garrett-archery/universal-finger-tab/README.md

# Universal Finger Tab

The goal of this project is to develop one finger tab that will work for every user.

Fork the repository to create your own project based on the Universal Finger Tab design.
Branch the Universal Finger Tab repository to propose changes to the Master. 

A production version of this project is available for purchase at <a href="https://garrettarchery.com/product/universal-finger-tab/">GarrettArchery.com</a>
