garrett-archery/universal-finger-tab/palm plate.step

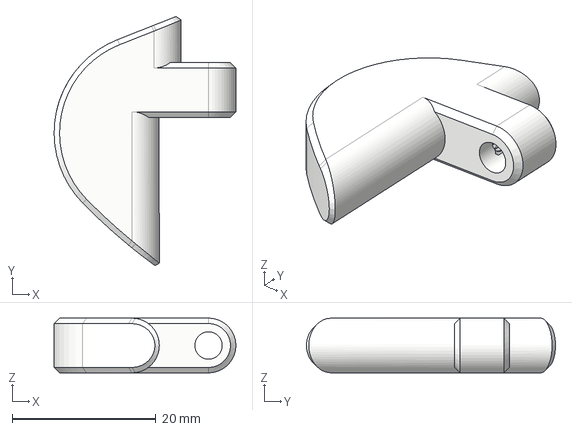
[picture p3: CAD file, 2019-08-01]
palm plate.step
25.3 x 34.7 x 7.62 mm
