garrett-archery/universal-finger-tab/Right hand/shelf - right-hand.step

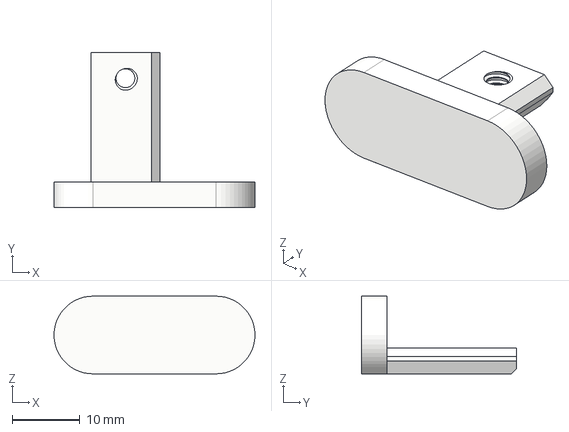
[picture p4: CAD file, 2019-08-01]
Right hand/shelf - right-hand.step
29.6 x 22.9 x 11.4 mm
