garrett-archery/universal-finger-tab/Left hand/finger spacer - left-hand.step

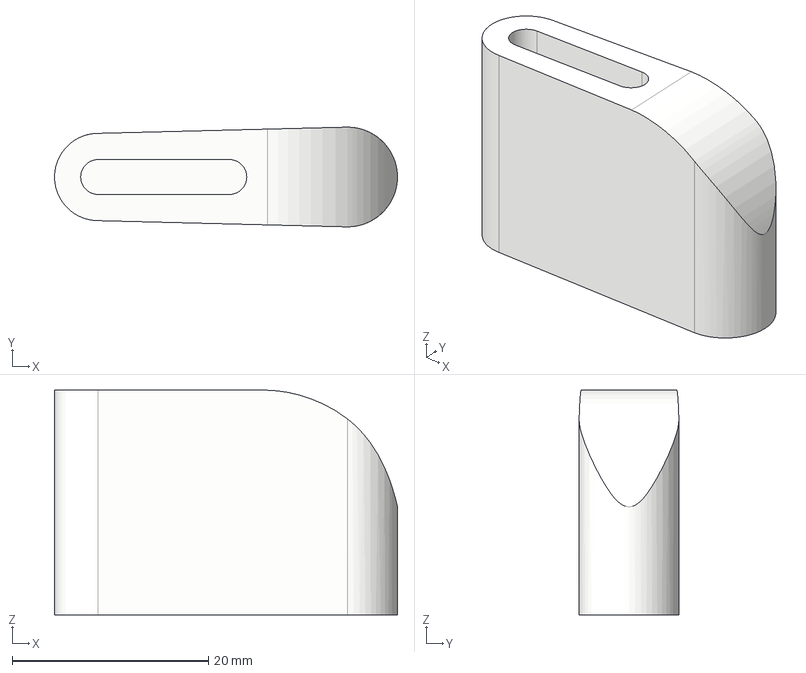
[picture p5: CAD file, 2019-08-01]
Left hand/finger spacer - left-hand.step
34.9 x 10.2 x 22.9 mm
