garrett-archery/universal-finger-tab/finger alignment plate.step

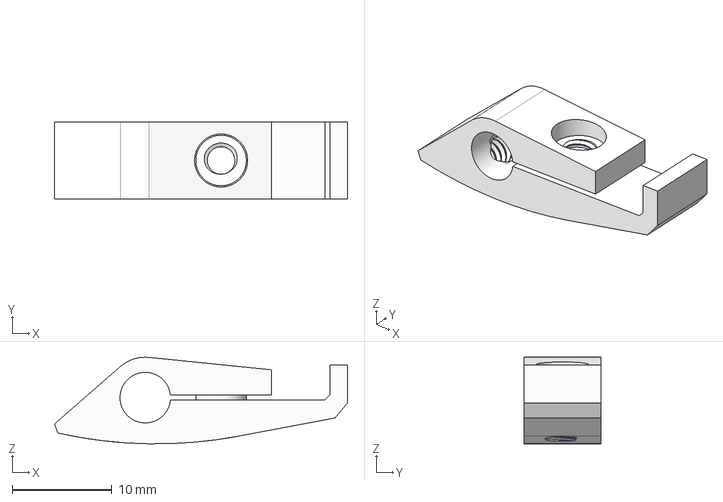
[picture p6: CAD file, 2019-08-01]
finger alignment plate.step
29.4 x 7.77 x 8.70 mm
