garrett-archery/universal-finger-tab/finger leather lock.step

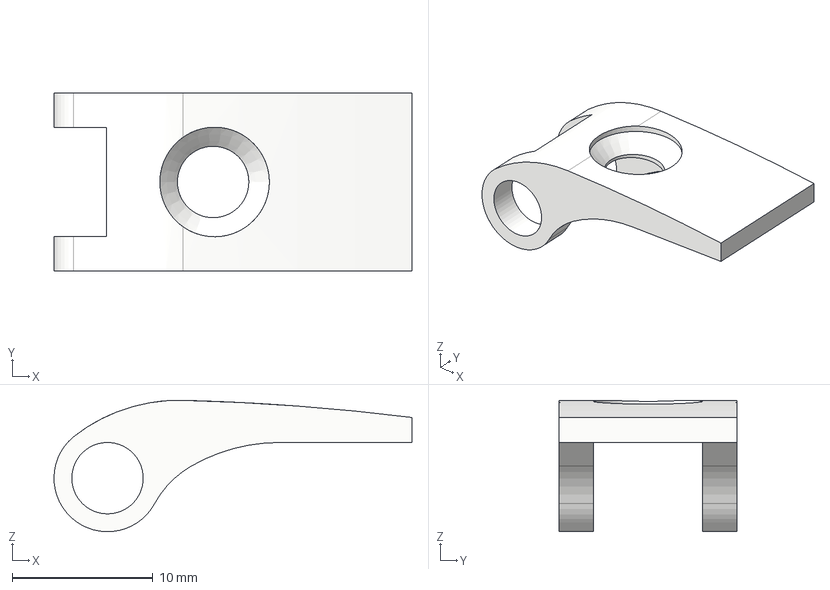
[picture p7: CAD file, 2019-08-01]
finger leather lock.step
25.5 x 12.7 x 9.35 mm
