garrett-archery/universal-finger-tab/(list of files, cad)

Other CAD files:
Right hand/body - right-hand.step
Left hand/shelf - left-hand.step
Right hand/finger spacer - right-hand.step
Assembly - Right Hand.f3z
